Ameed-Rajab/Smart-Incubator-/IMG_8288.jpeg

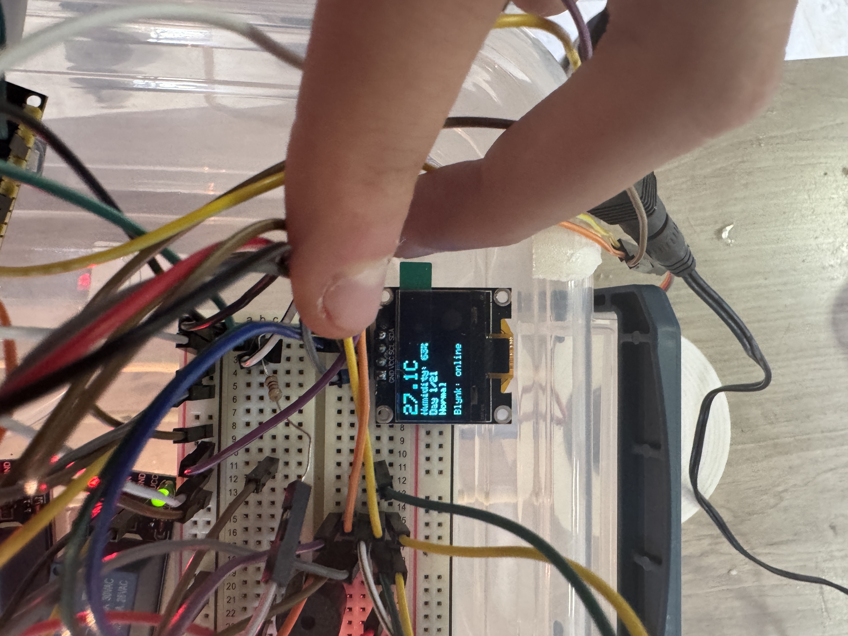
IMG_8288.jpeg
