Ameed-Rajab/Smart-Incubator-/IMG_8284.jpeg

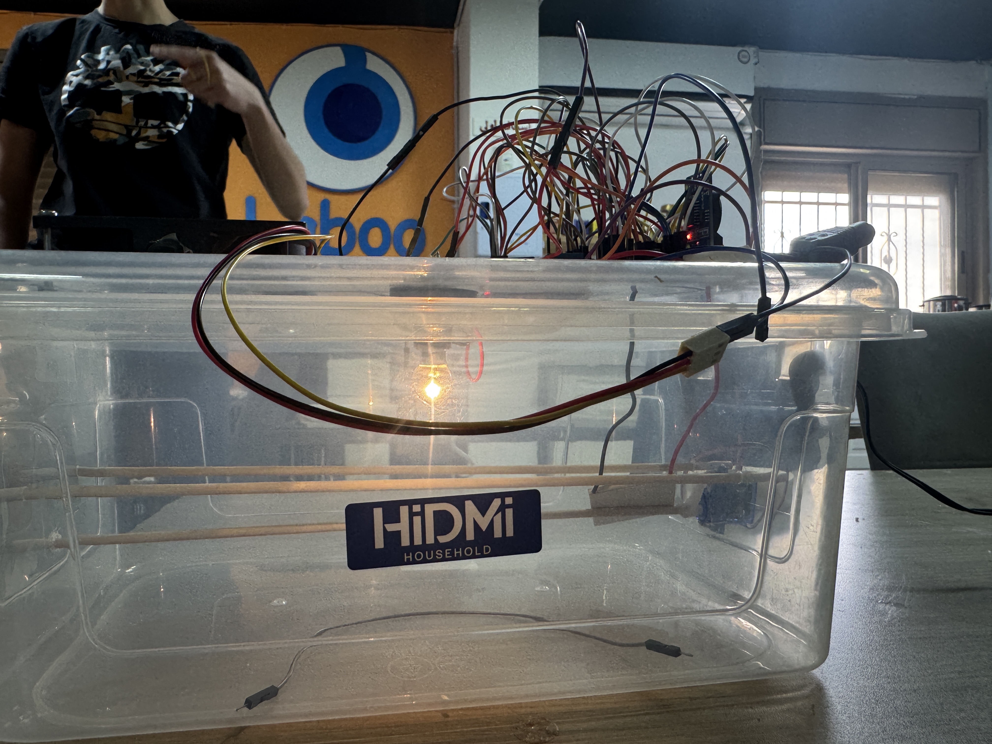
IMG_8284.jpeg
