Ameed-Rajab/Smart-Incubator-/IMG_8279.jpeg

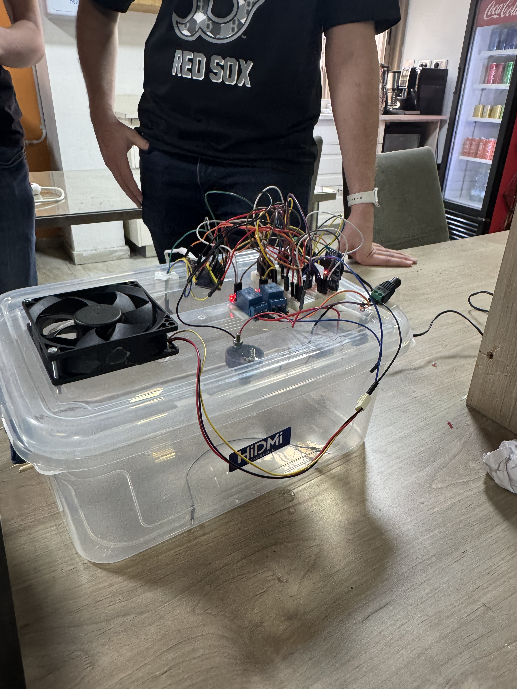
IMG_8279.jpeg
