Ameed-Rajab/Smart-Incubator-/IMG_8280.jpeg

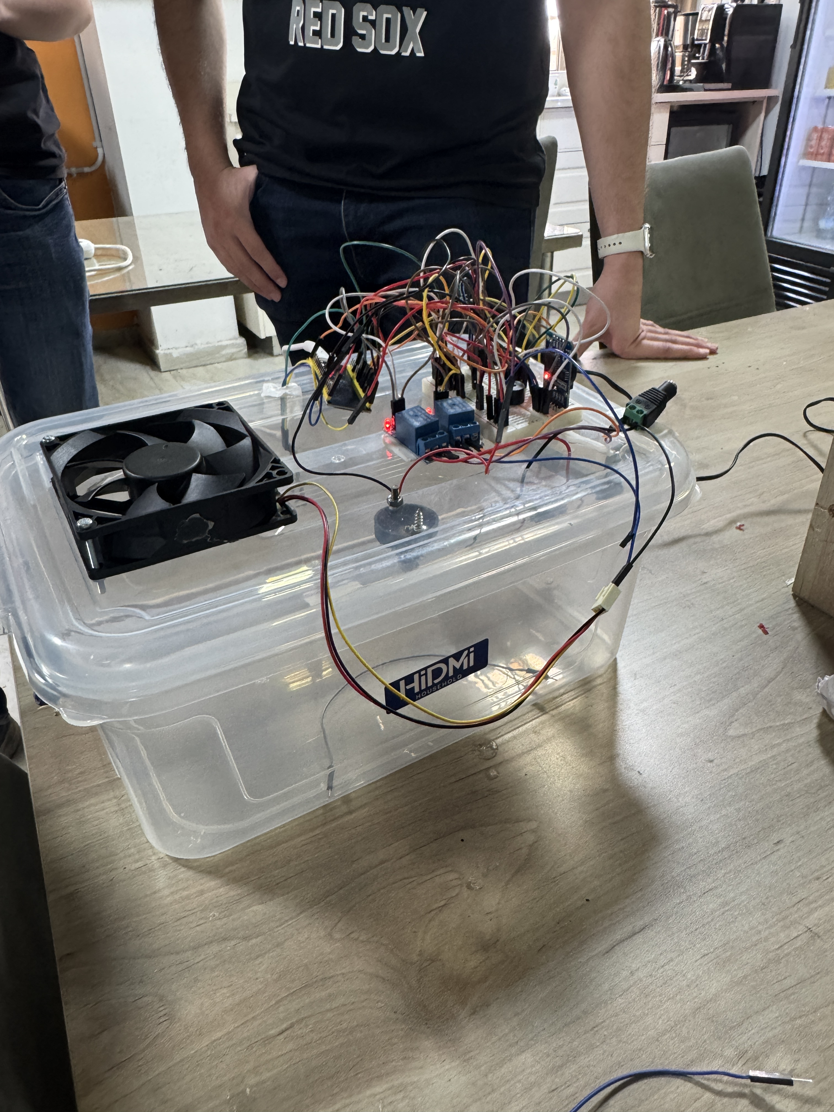
IMG_8280.jpeg
