Ameed-Rajab/Smart-Incubator-/IMG_8282.jpeg

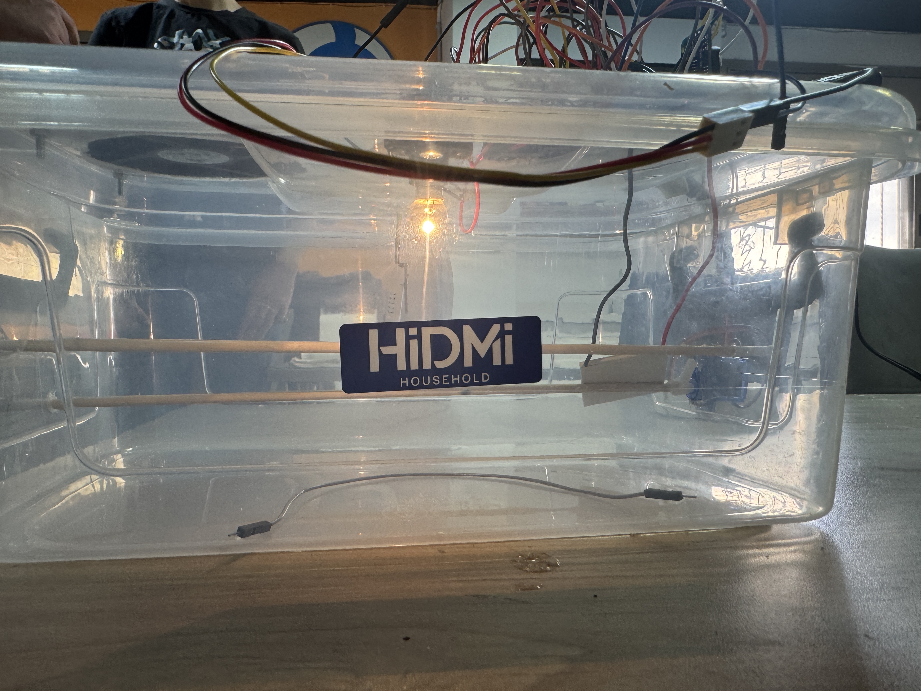
IMG_8282.jpeg
