Ameed-Rajab/Smart-Incubator-/IMG_8283.jpeg

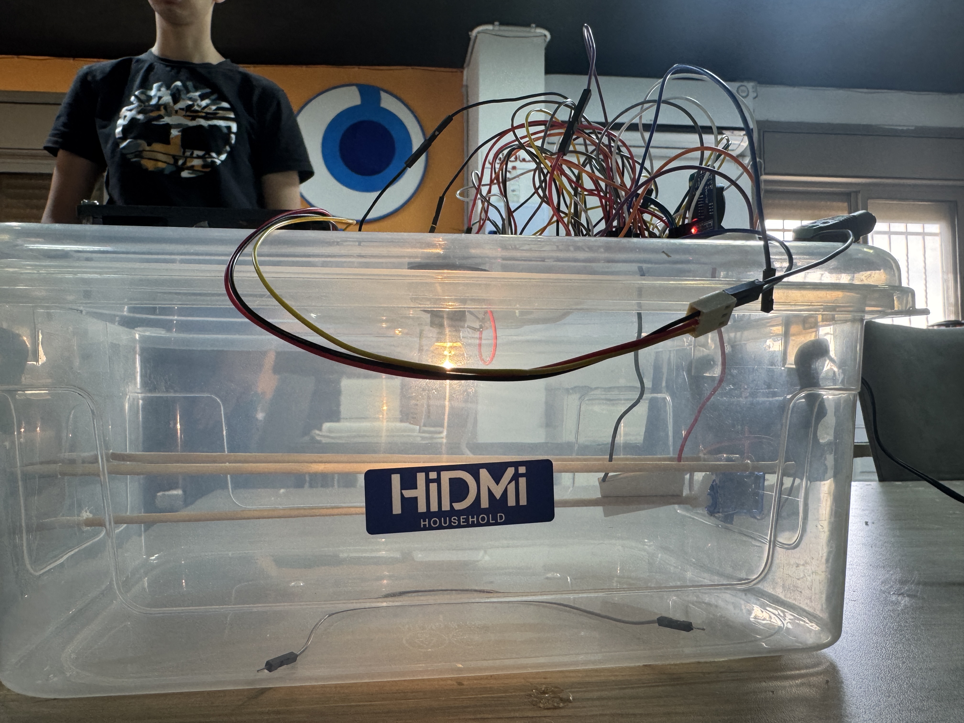
IMG_8283.jpeg
